SebastianDevy/gas_detector/README.md

# Gas Detector Project

This repository contains a past project: a gas detection system built with an ESP32, MQ-5 sensor, buzzer, and Blynk integration.

## Overview
 Detects flammable gases and triggers alerts.
 Specifically Methane, Carbon Monoxide and other dangerous gasses.
 Provides live monitoring and manual buzzer control via the Blynk app.
 Focused on safety and real-time responsiveness.
 For full documentation please refer to the docs and see report and research plan.

## Achievement
 Eskom Expo 2025 : Stellenbosch University Best Senior Engineering Award, Engineering Category:
 Air Aware (ESP32 Air Quality Detection System)

## Status
 Archived as part of my portfolio, this project was done in 2025.
 Represents my early work in electronics and IoT.
 Note that the program will not work for the blynk account was terminated after prolonged inactivity.

## Partner Acknowledgement
 This project was built in collaboration with Lubin Venter. Lubin contributed to project conceptualisation, component procurement, documentation and assistance with assembly. I was responsible for all hardware assembly and software development.
