SebastianDevy/gas_detector/results/Eskom Expo.pdf

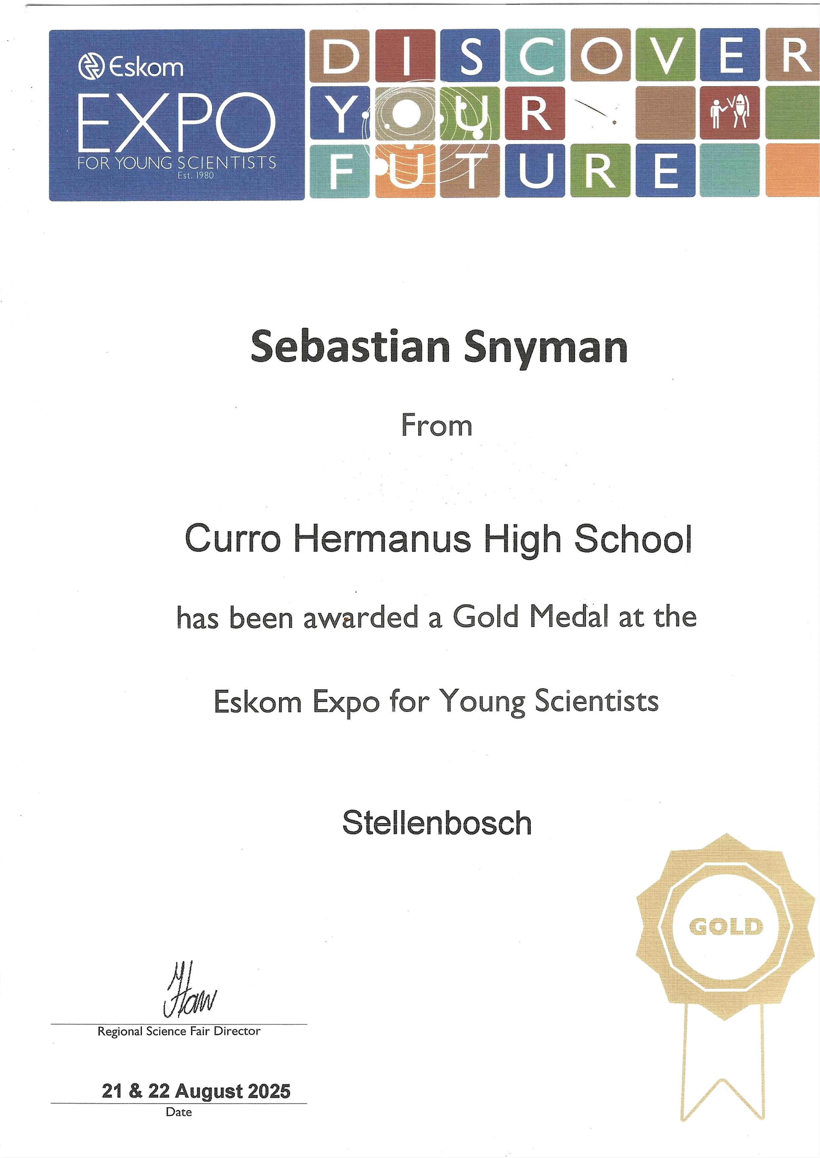
[picture p26: page 1]
